Brickworks/Brickworks-Card-Templates/HAB-Main-Flight-Computer-Card-Template/MFC-Card-TemplateV2.step

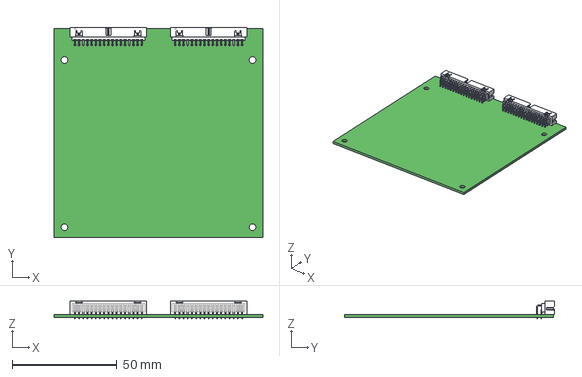
[picture p1: CAD file, 2020-08-18]
HAB-Main-Flight-Computer-Card-Template/MFC-Card-TemplateV2.step
100.0 x 100.7 x 8.46 mm
