Brickworks/Brickworks-Card-Templates/HAB-Payload-Card-Template/Payload-Card-TemplateV2.step

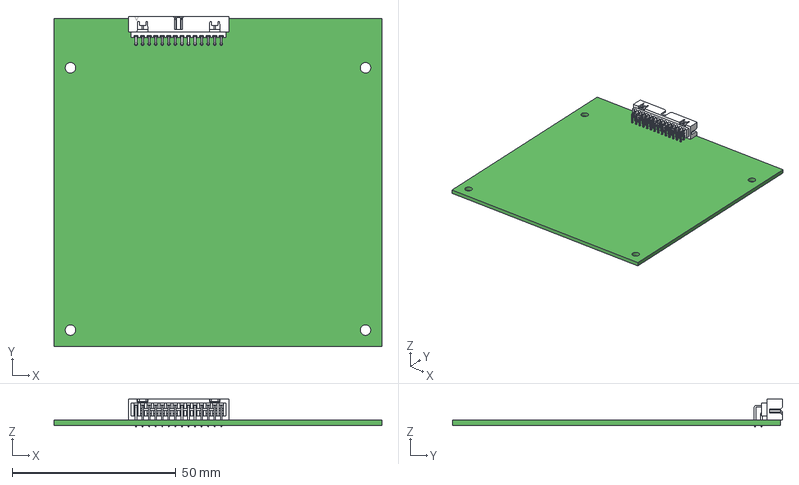
[picture p2: CAD file, 2020-08-18]
HAB-Payload-Card-Template/Payload-Card-TemplateV2.step
100.0 x 100.6 x 8.46 mm
