Brickworks/Brickworks-Card-Templates/HAB-Main-Flight-Computer-Card-Template/MFC-Card-TemplateV1.step

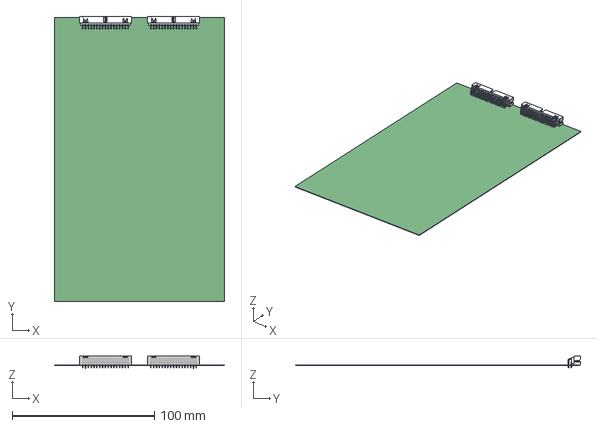
[picture p3: CAD file, 2020-08-17, an earlier design]
HAB-Main-Flight-Computer-Card-Template/MFC-Card-TemplateV1.step
120.0 x 200.7 x 8.46 mm
