Brickworks/Brickworks-Card-Templates/HAB-Payload-Card-Template/Payload-Card-TemplateV1.step

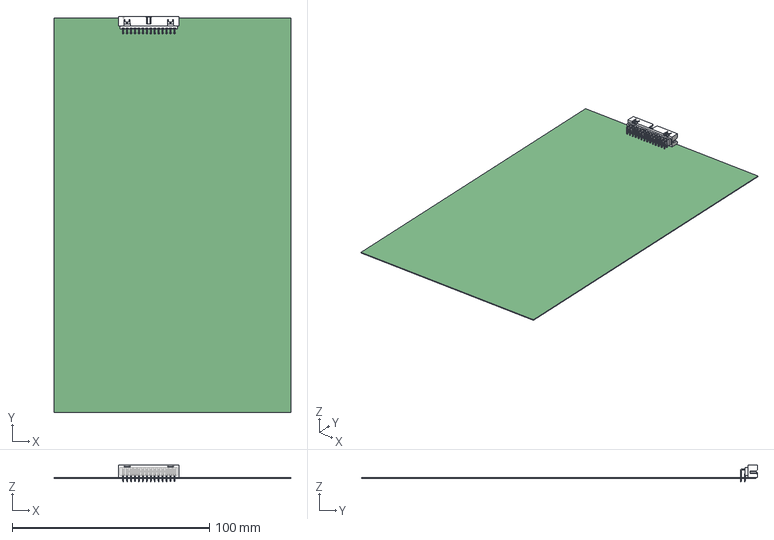
[picture p4: CAD file, 2020-08-17, an earlier design]
HAB-Payload-Card-Template/Payload-Card-TemplateV1.step
120.0 x 200.6 x 8.46 mm
