Brickworks/Brickworks-Card-Templates/HAB-Main-Flight-Computer-Card-Template/HAB-Main-Flight-Computer-Card-Template.pdf

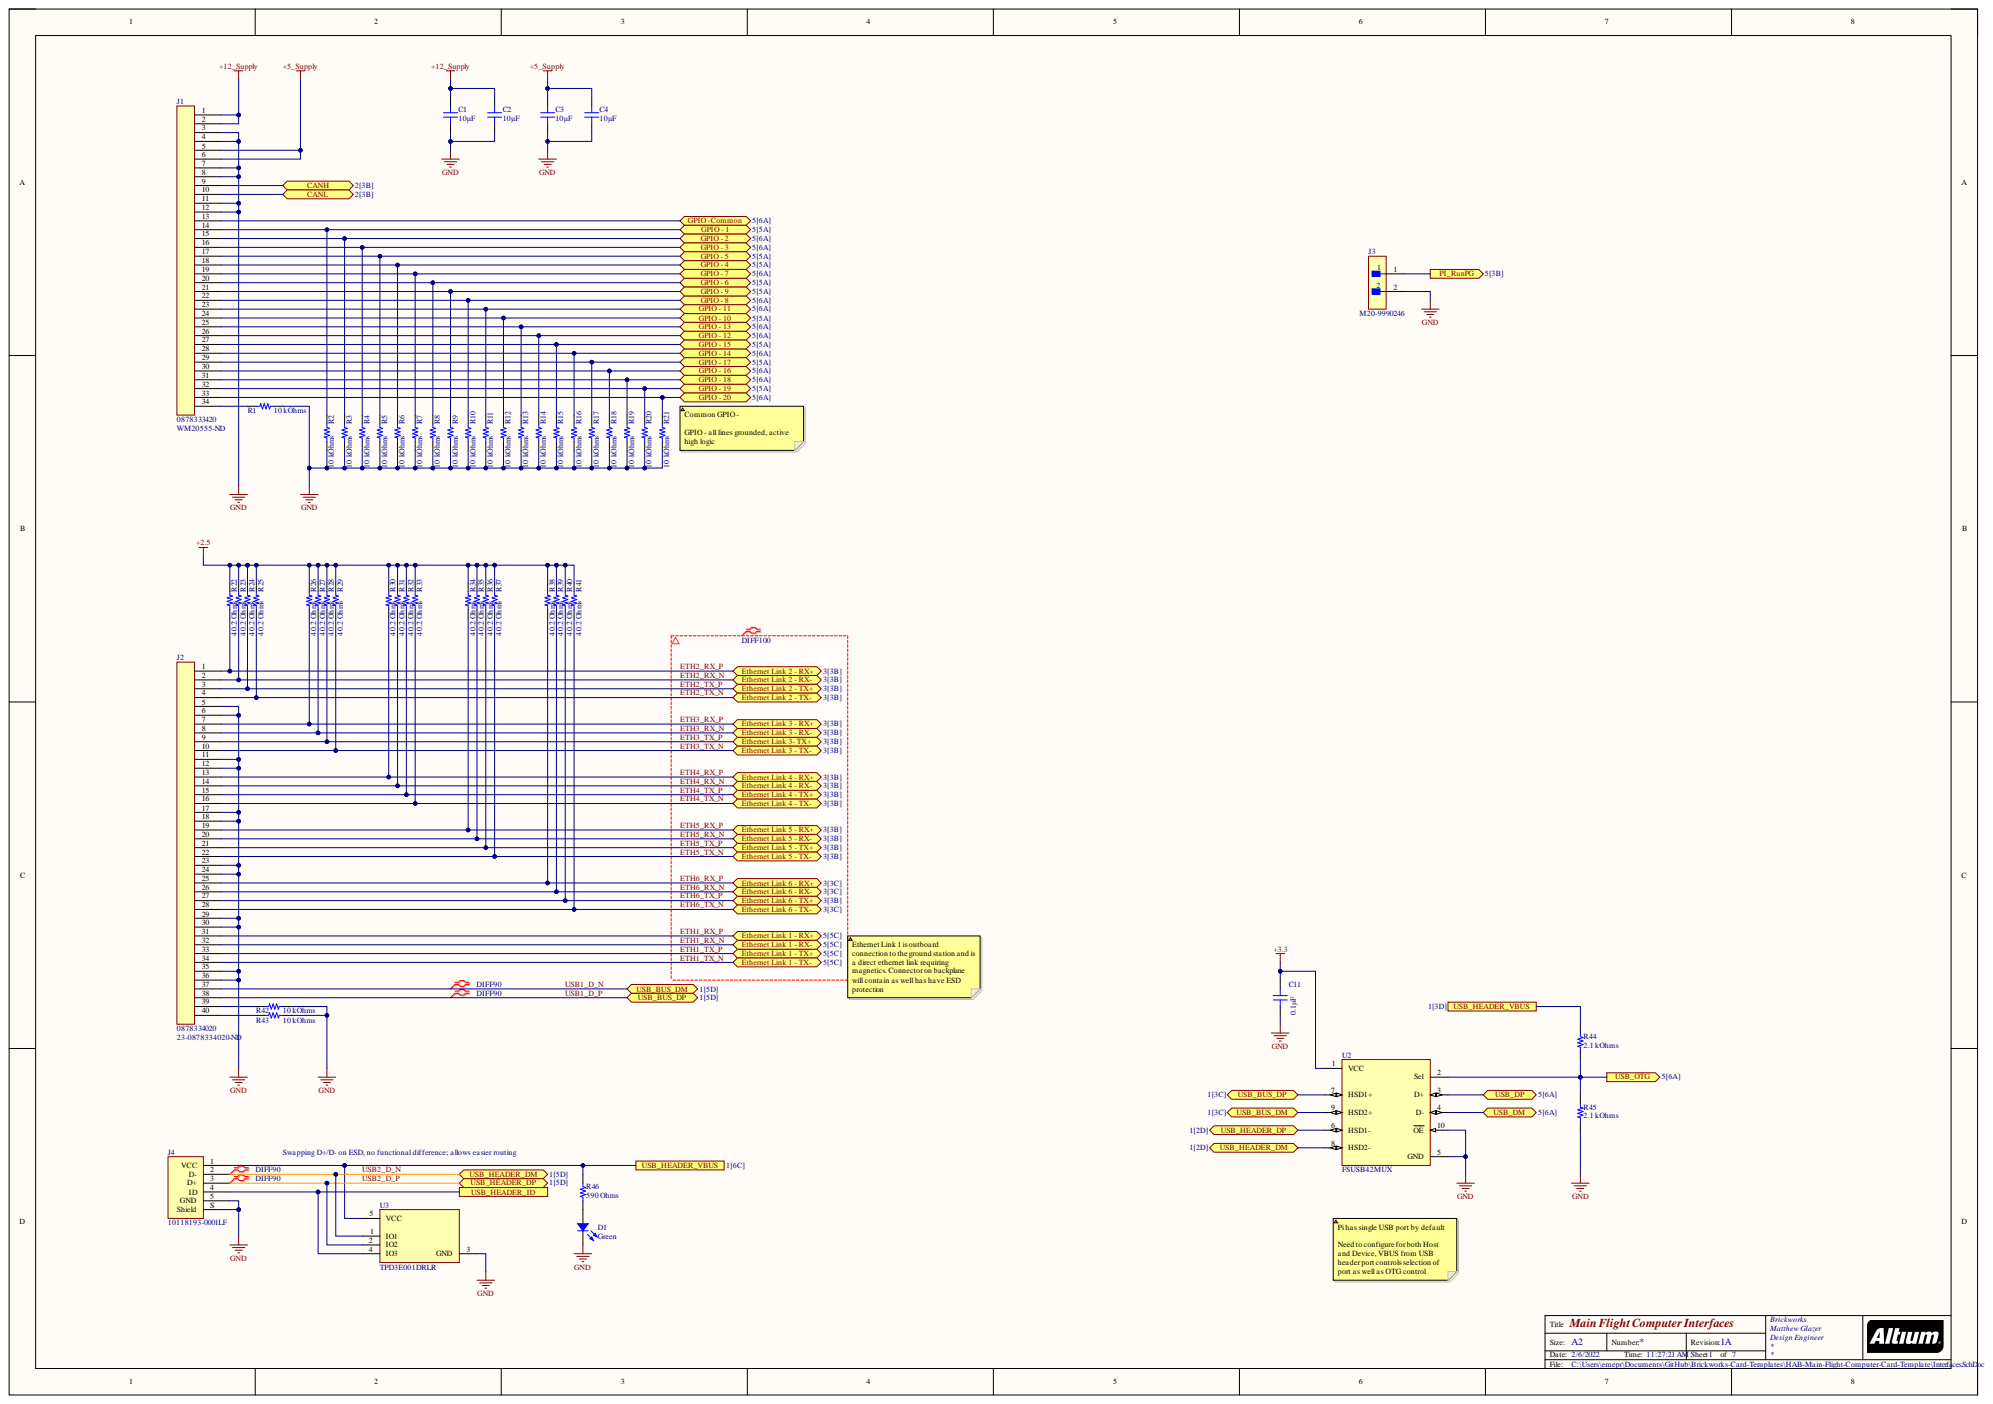
[picture p5: page 1]

GPIO - all lines grounded, active
high logic

Ethernet Link 1 is outboard
connection to the ground station and is
a direct ethernet link requiring
magnetics.Connector on backplane
will contain as well has have ESD
protection

36
37
38 | DIFF90 USB1_D_P

Swapping D+/D- on ESD, no functional difference; allows easier routing

DIFF90

Pi has single USB port by default

Need to configure for both Host
and Device, VBUS from USB
header port controls selection of
port as well as OTG control

C:\Users\emepr\Documents\GitHub\Brickworks-Card-Templates\HAB-Main-Flight-Computer-Card-Template\Interfaces.SchDoc

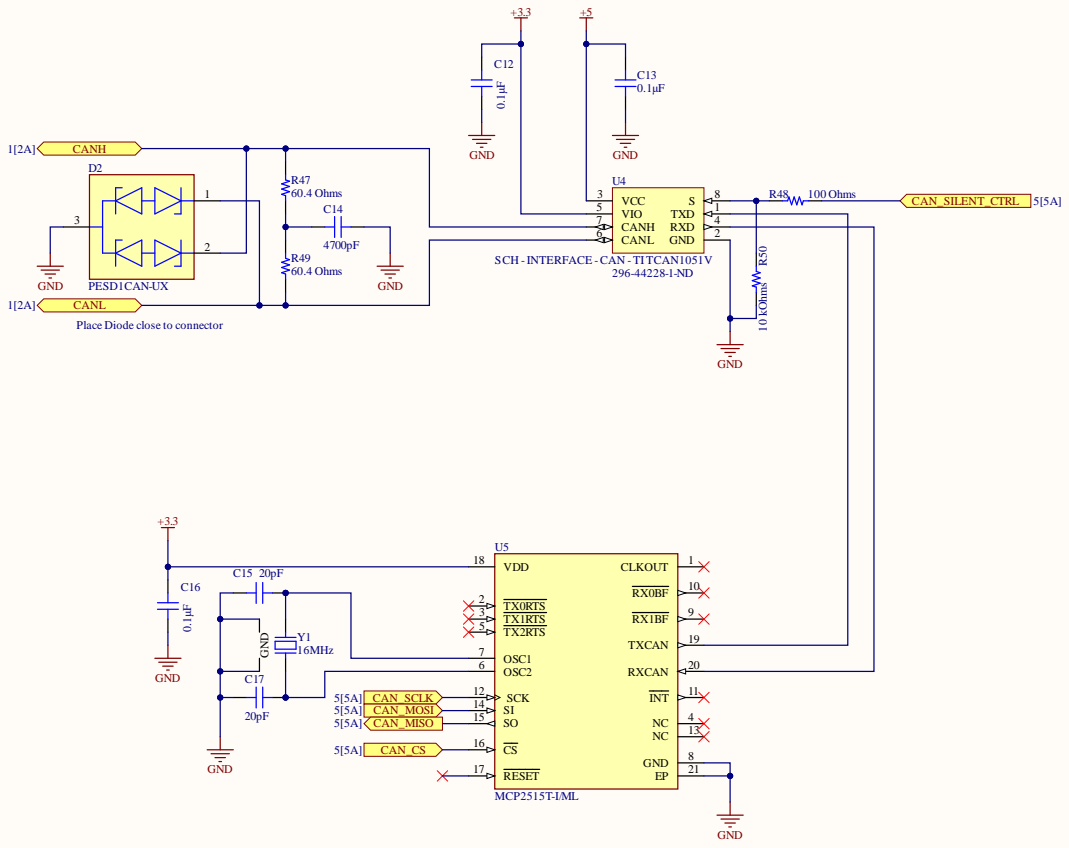
[picture p6: page 2]

Place Diode close to connector

Main Flight Computer CAN Bus
Title

C:\Users\emepr\Documents\GitHub\Brickworks-Card-Templates\HAB-Main-Flight-Computer-Card-Template\CANbus.SchDoc

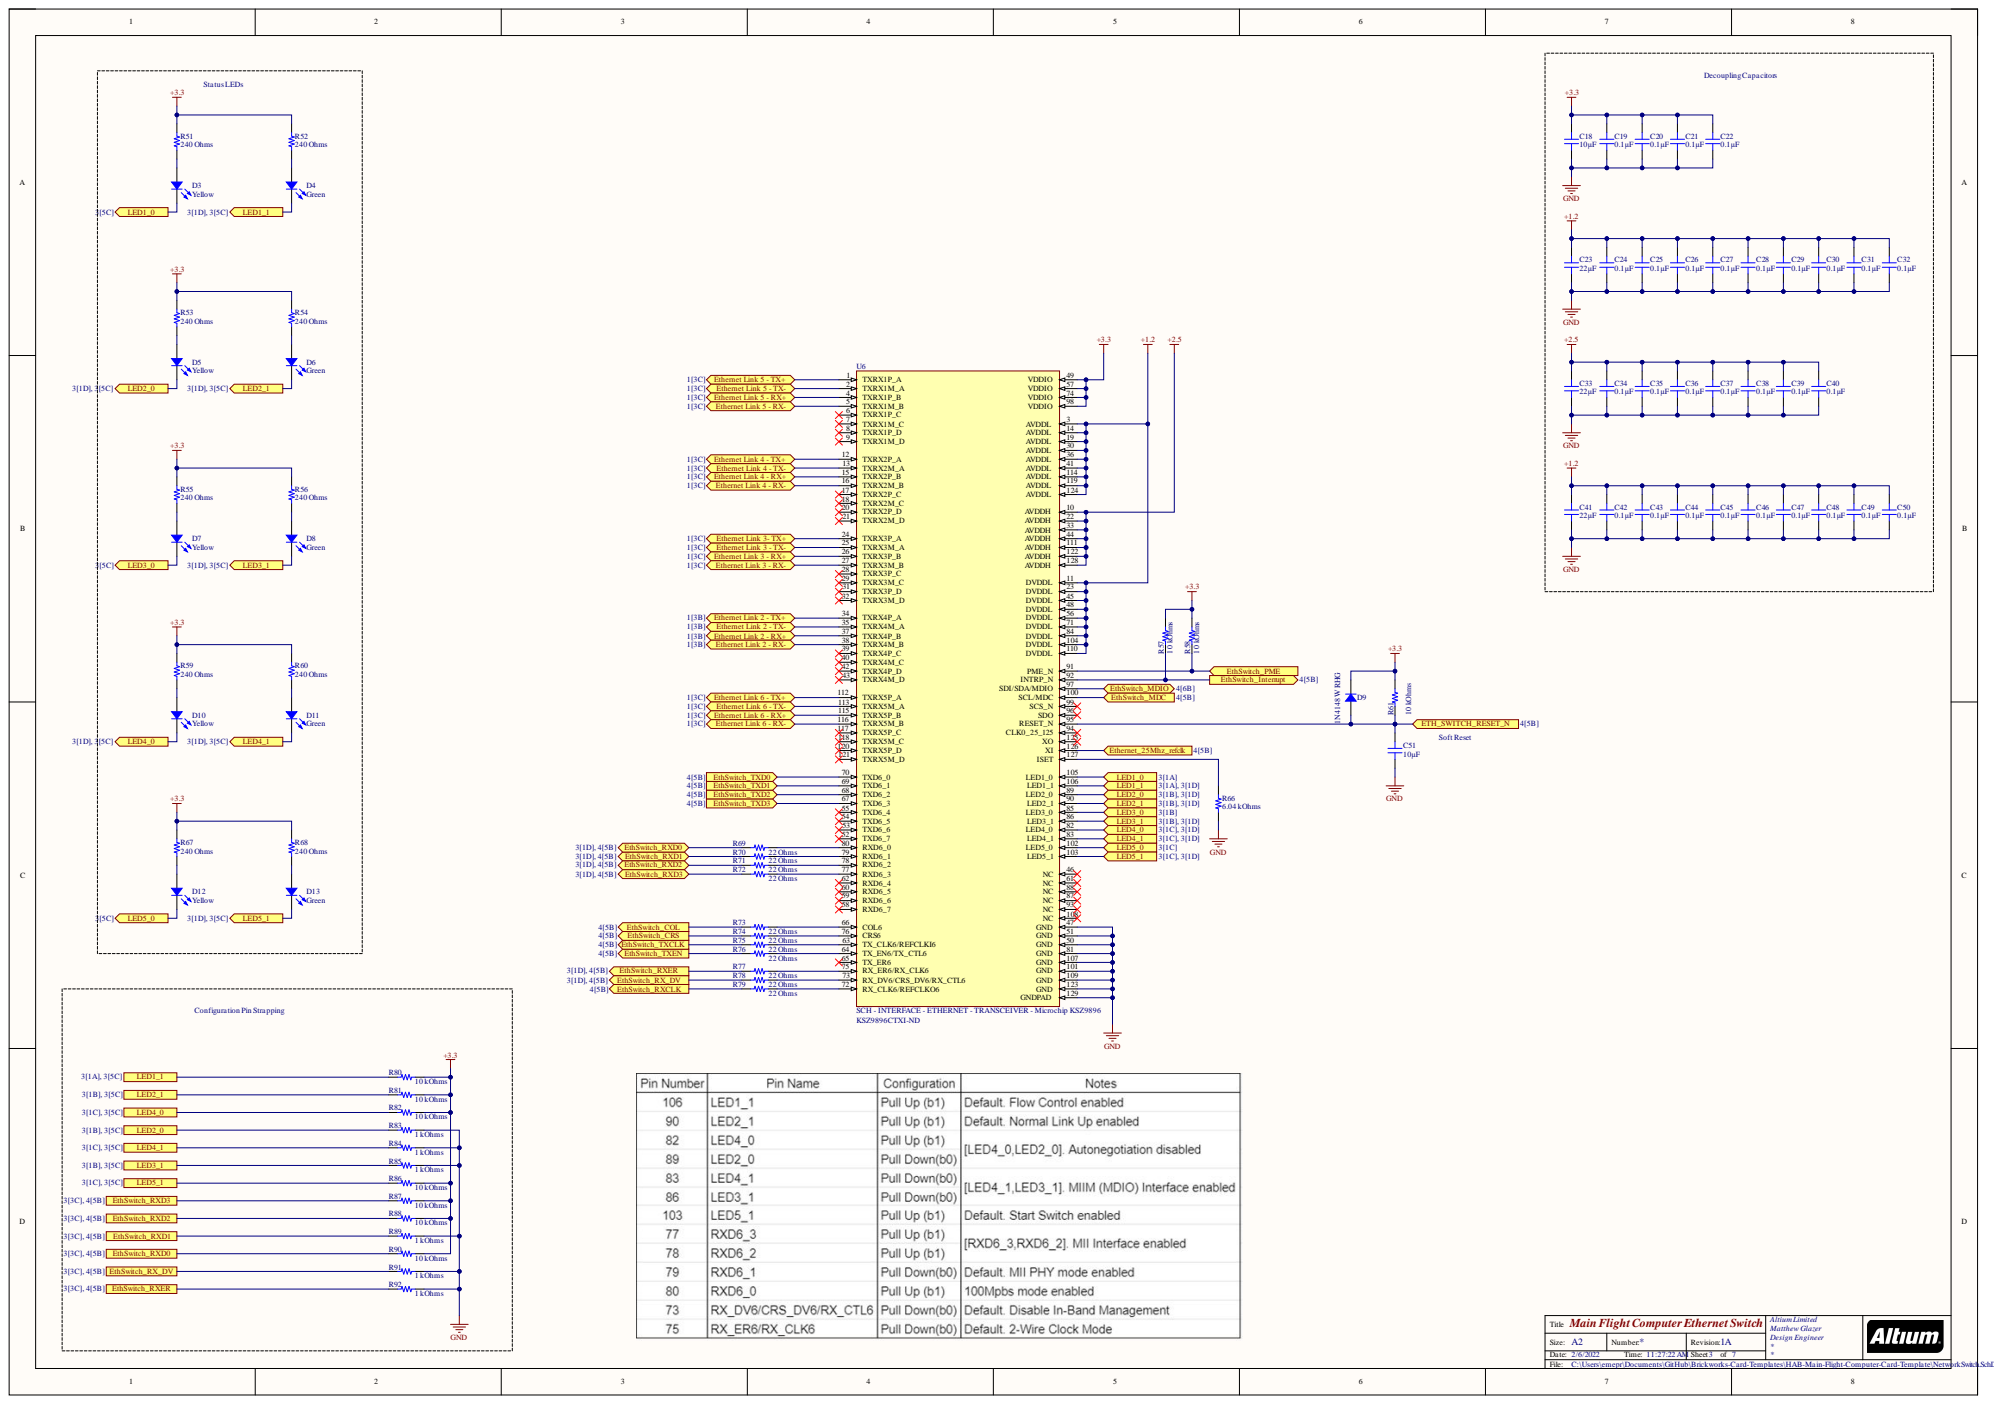
[picture p7: page 3]

5 1
5 0

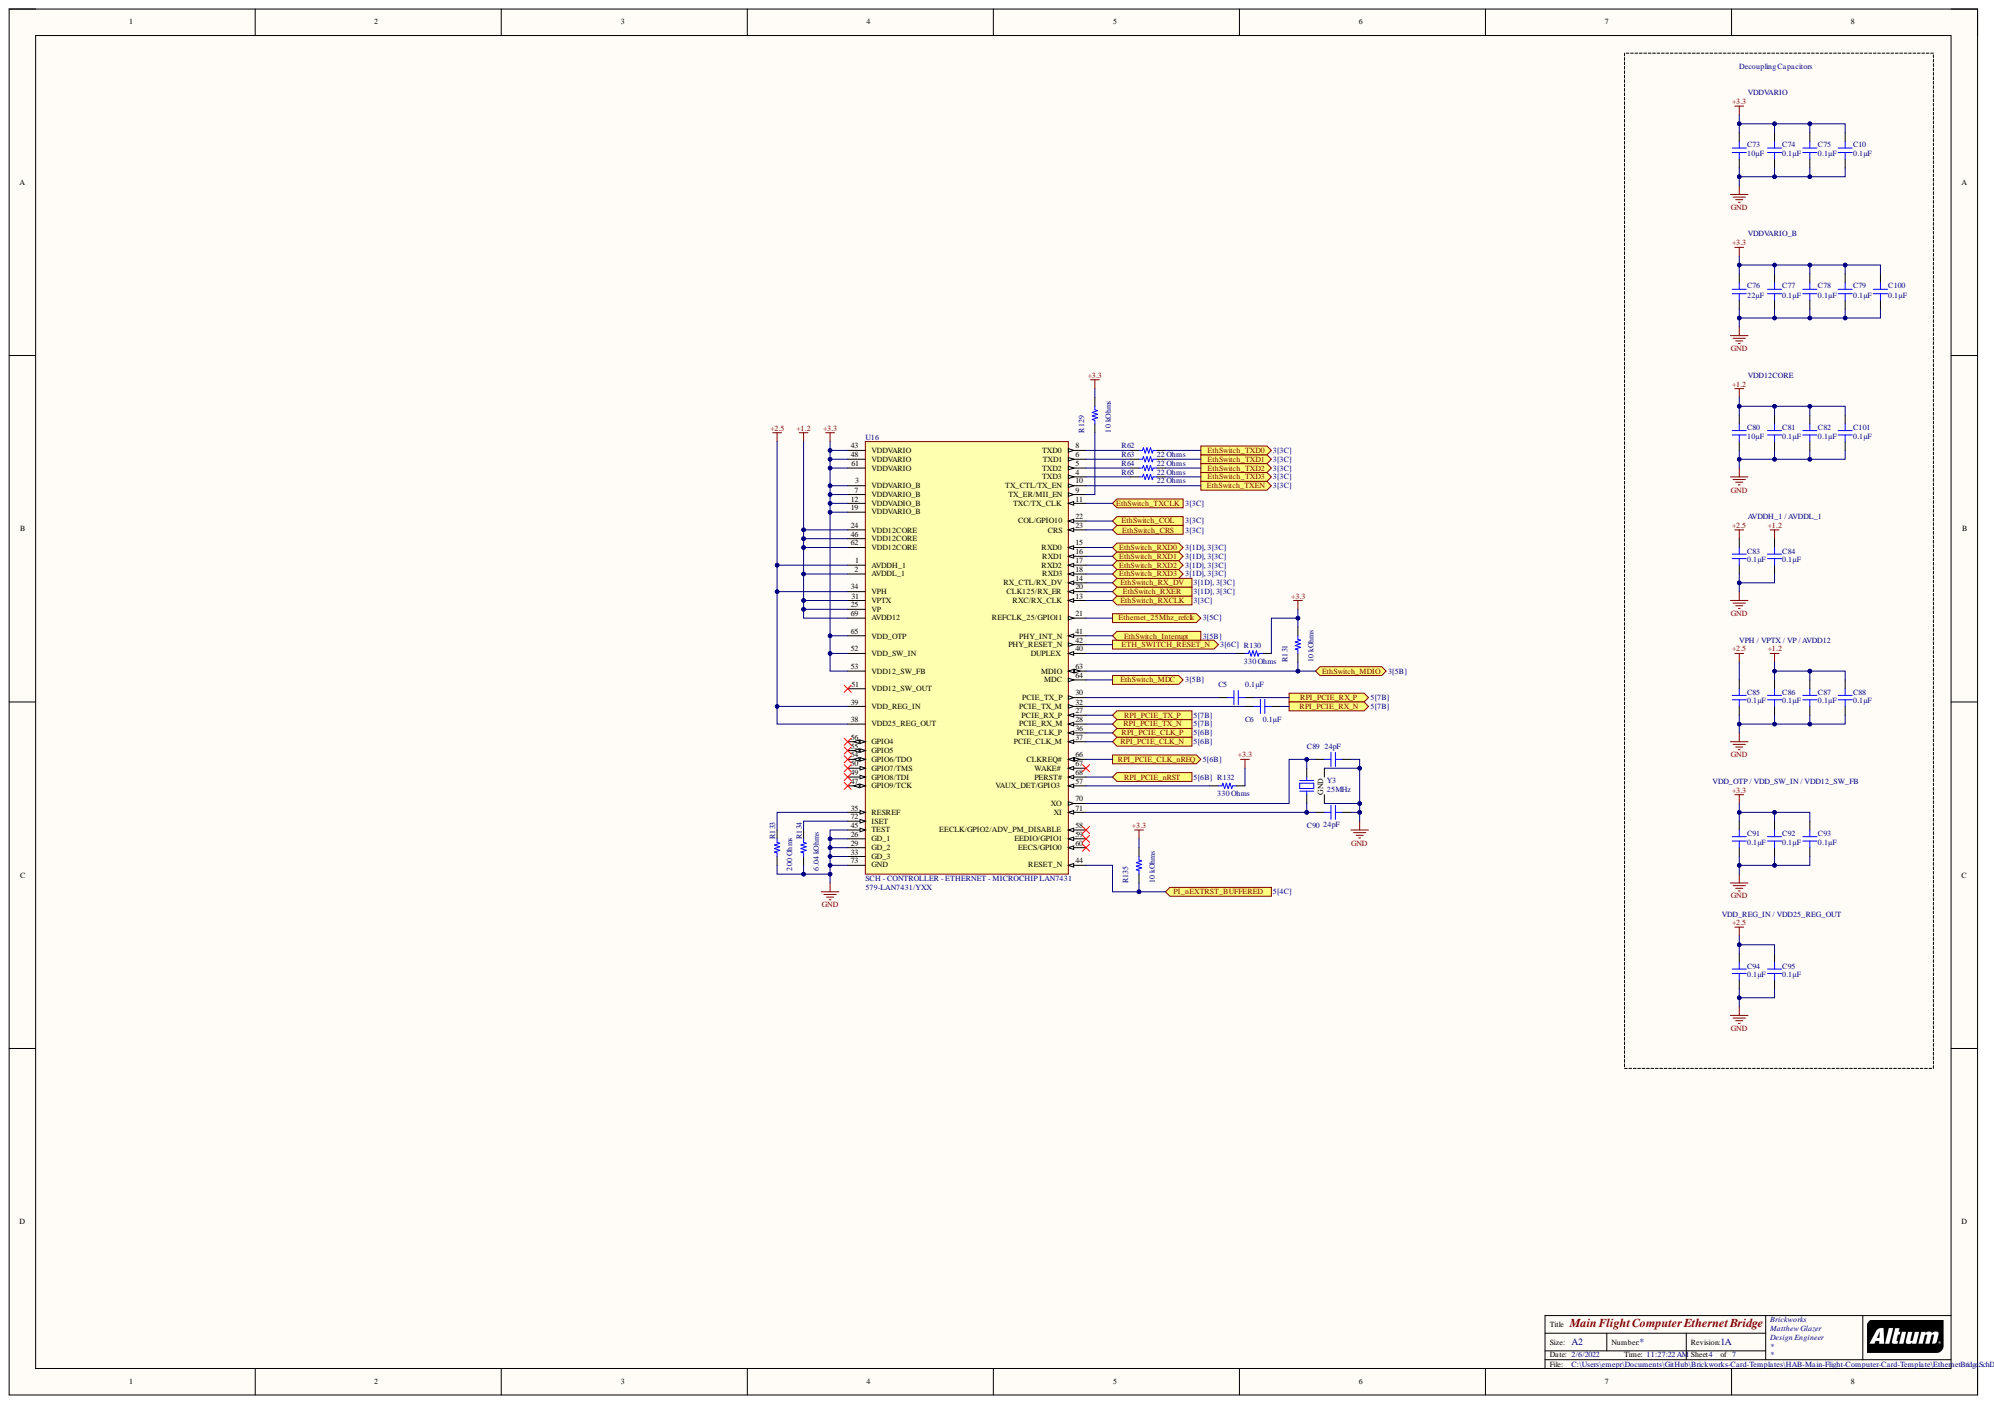
[picture p8: page 4]

4 6
6 2

3 4
3 1
2 5
6 9

6 7 | R P I _ P C IE_ CLK_ n REQ 5 [ 6 B ] 3 3 0 O hms
6 8 5 7 7 0 | | Y 3 2 5 M H z

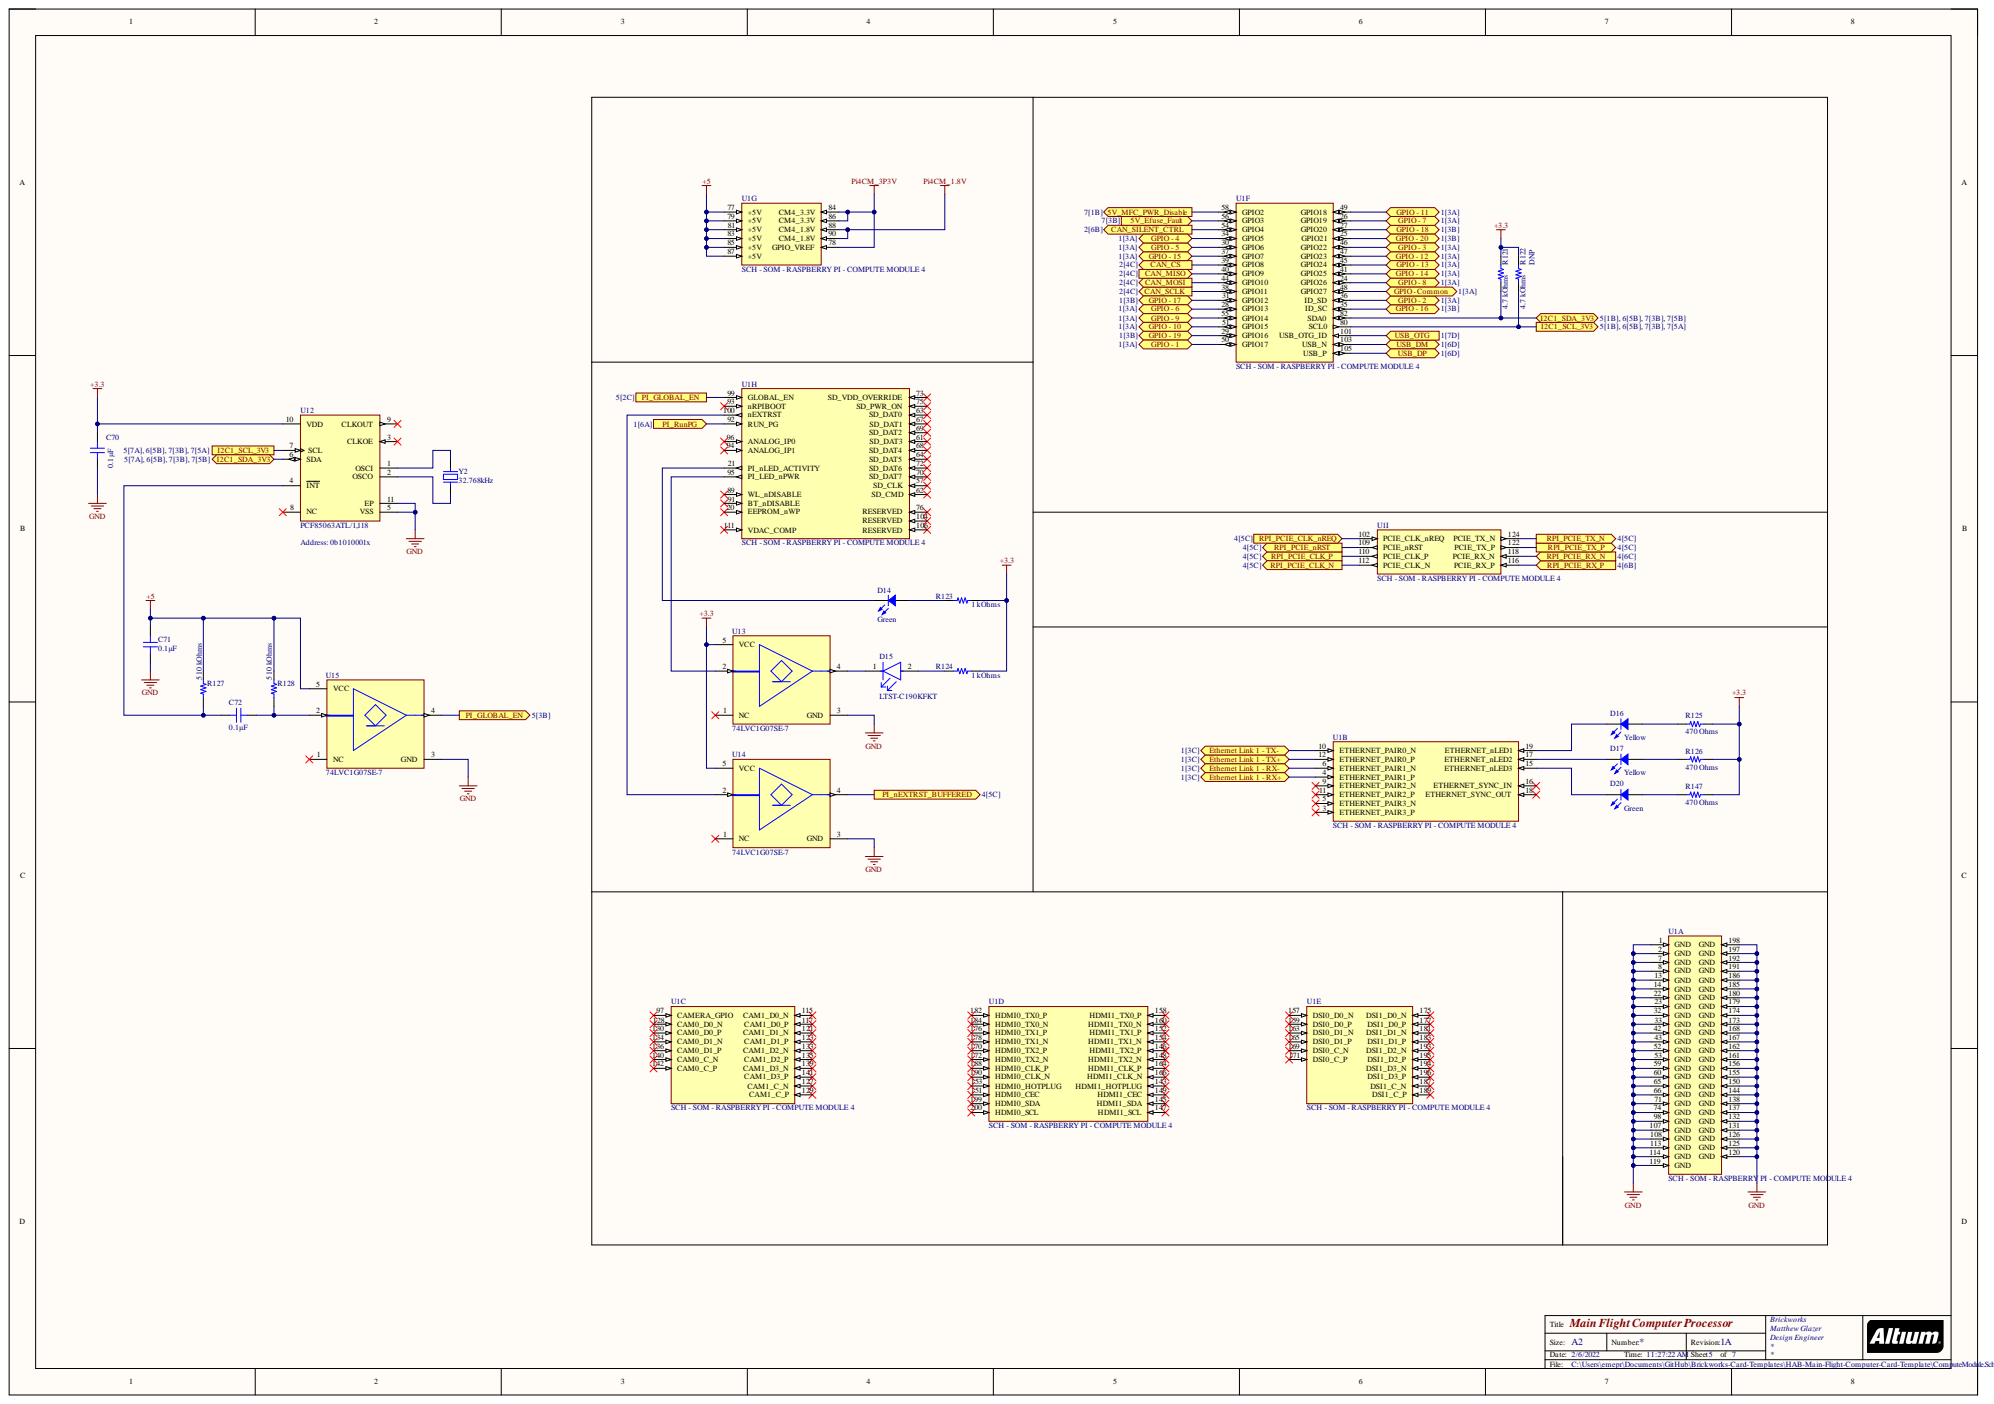
[picture p9: page 5]

SCH - SOM - RASPBERRY PI - COMPUTE MODULE 4

PI_LED_nPWR 95

WL_nDISABLE 89

C:\Users\emepr\Documents\GitHub\Brickworks-Card-Templates\HAB-Main-Flight-Computer-Card-Template\ComputeModule.SchDoc

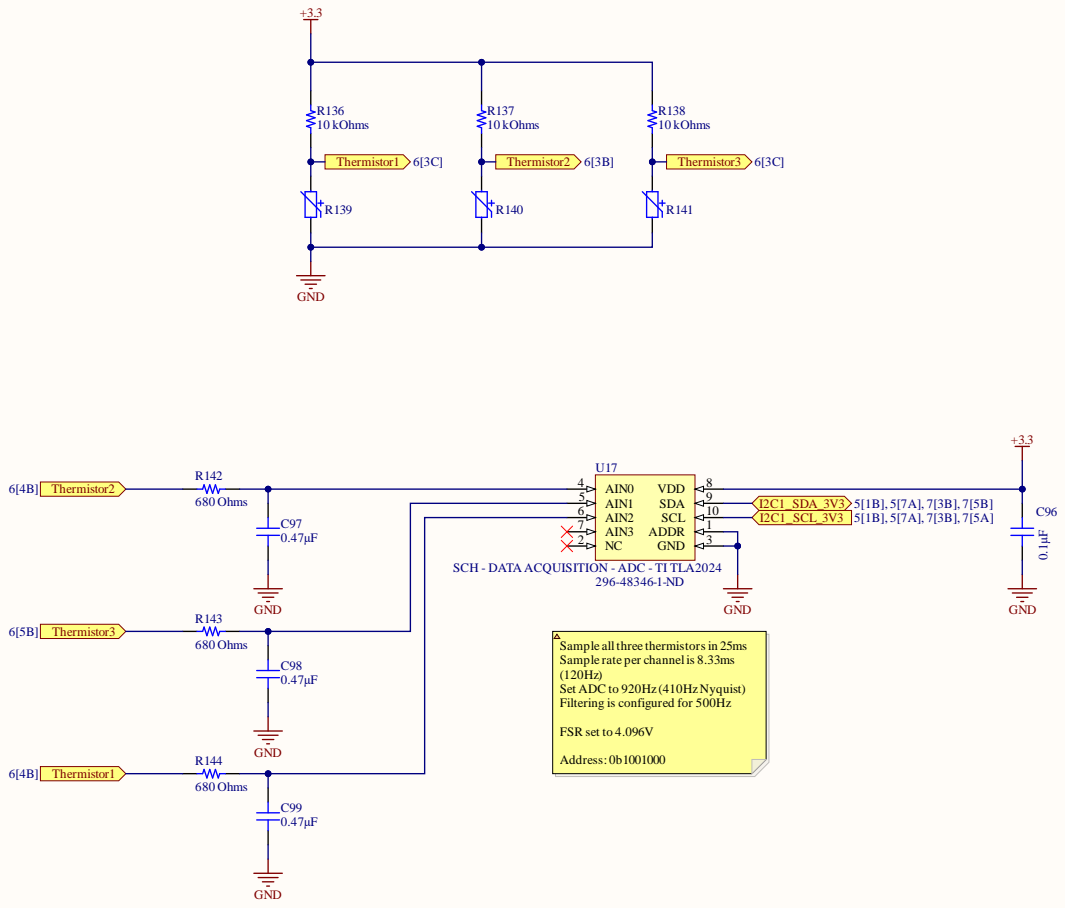
[picture p10: page 6]

SCH - DATA ACQUISITION - ADC - TI TLA2024

Sample all three thermistorsin 25ms
Sample rate per channel is 8.33ms
Set ADC to 920Hz (410HzNyquist)
Filtering is configured for 500Hz

Main Flight Computer Sensors
Title

C:\Users\emepr\Documents\GitHub\Brickworks-Card-Templates\HAB-Main-Flight-Computer-Card-Template\Sensors.SchDoc

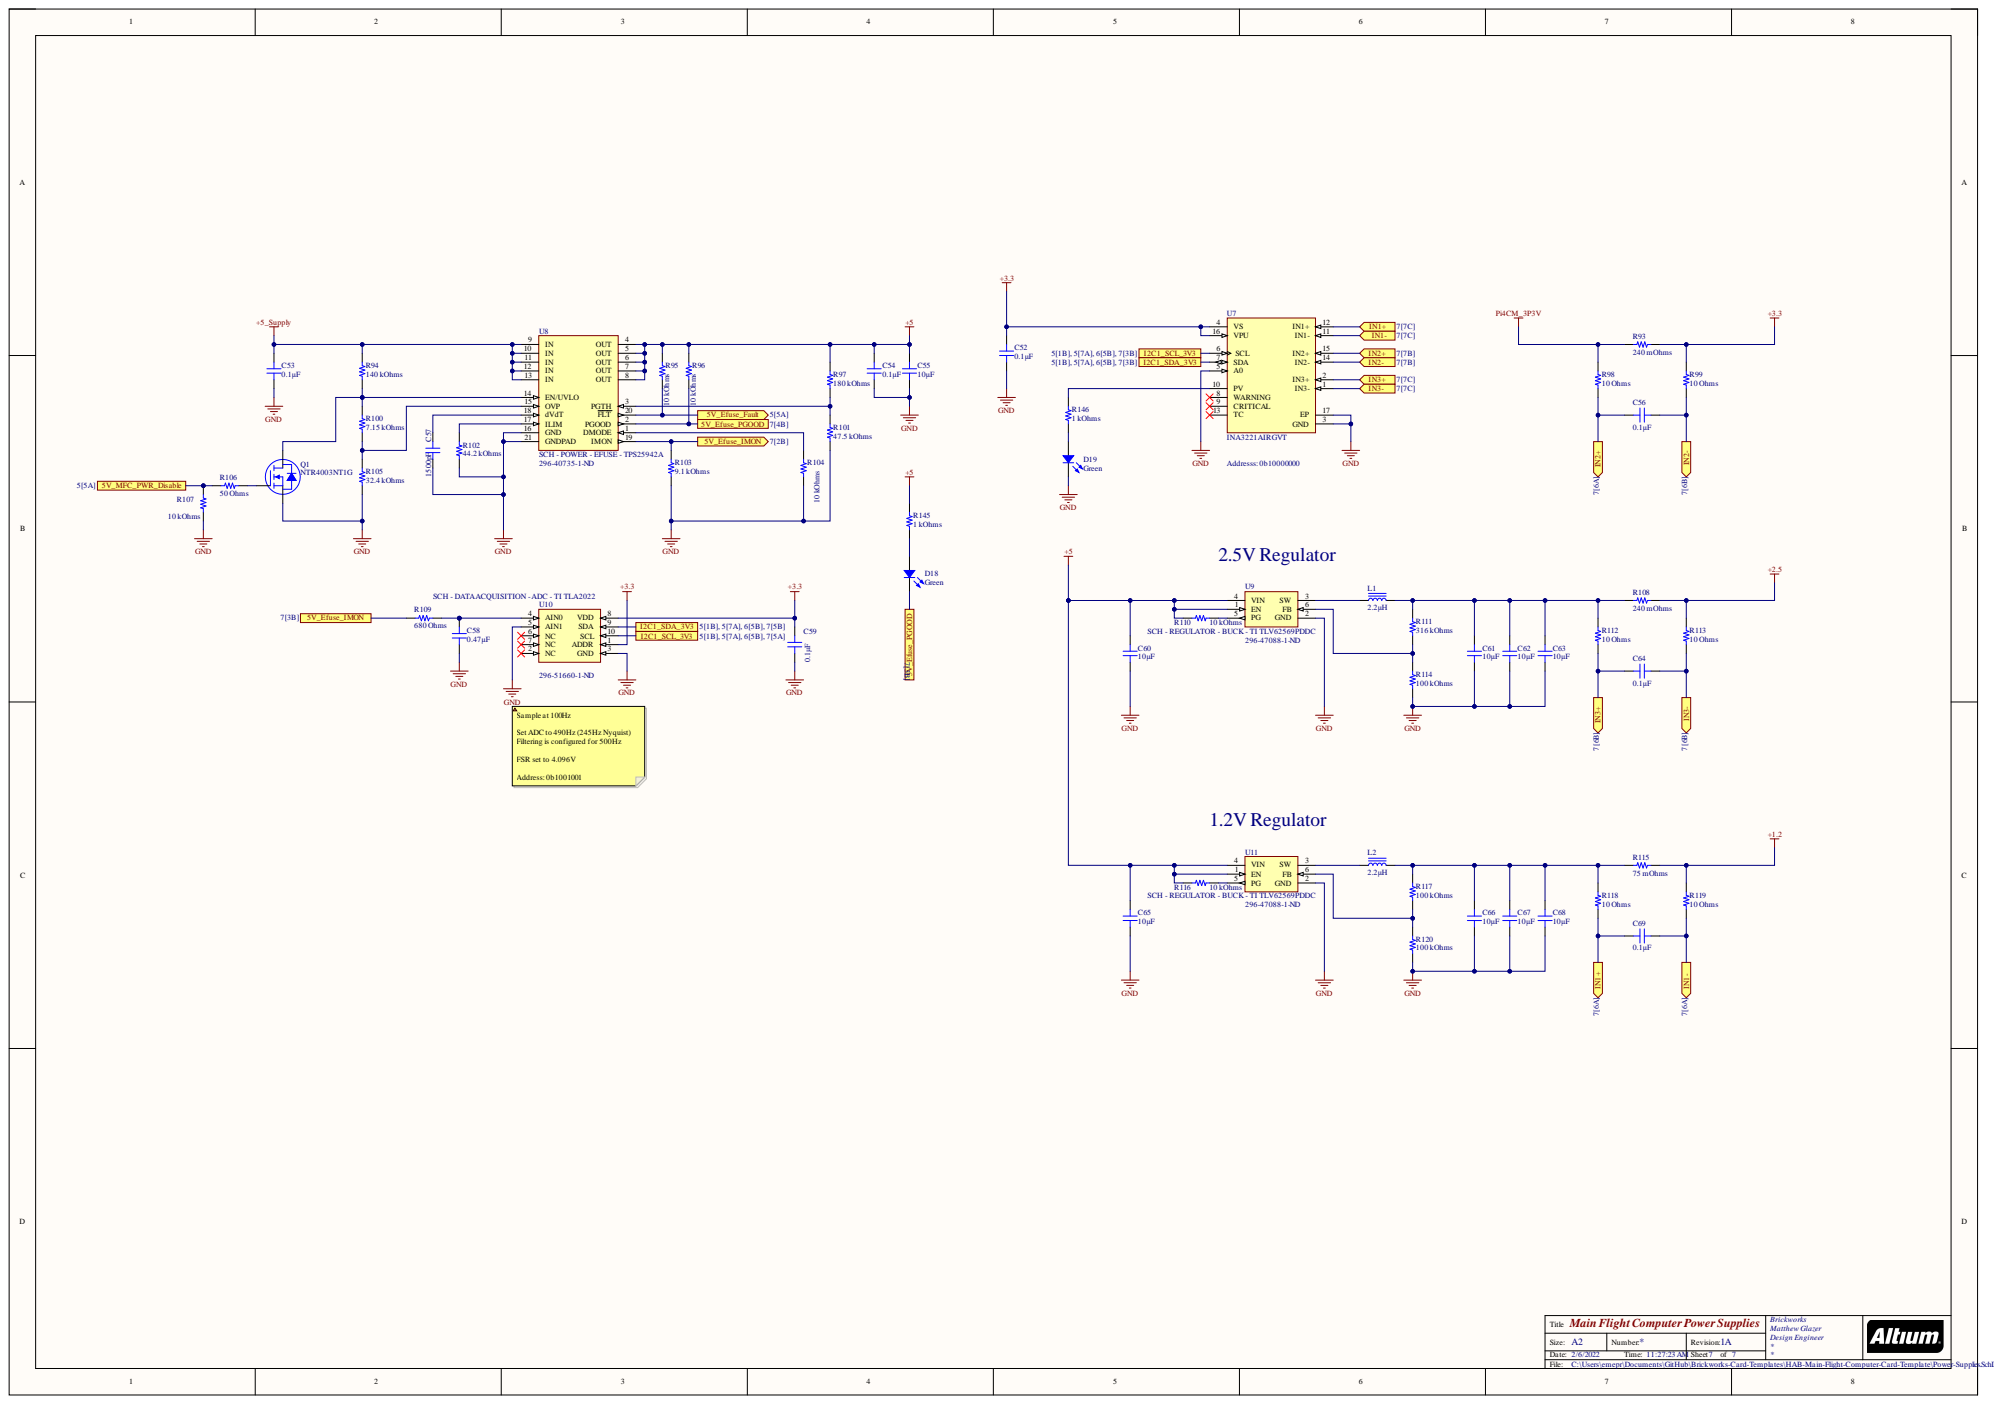
[picture p11: page 7]

2 1 | | 5 V_Efuse _ I M ON 7 [ 2 B ]

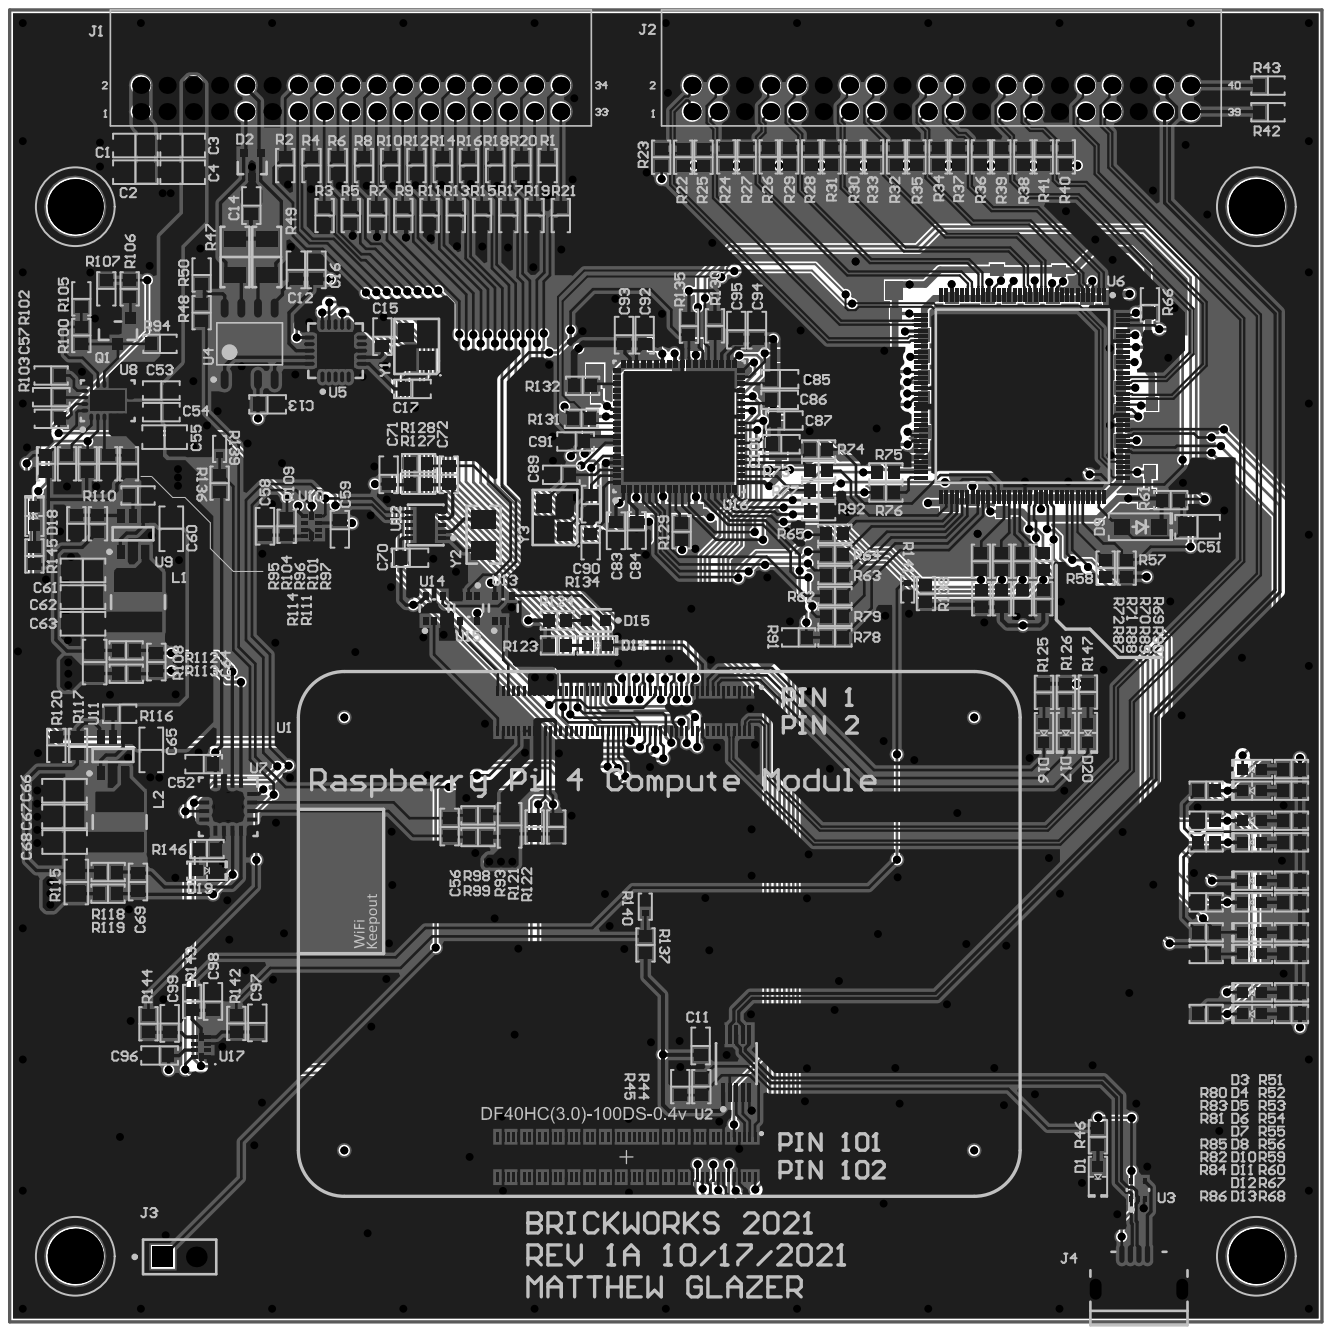
[picture p12: page 8]
