Brickworks/Brickworks-Card-Templates/HAB-Main-Flight-Computer-Card-Template/MFC_Draftsman.pdf

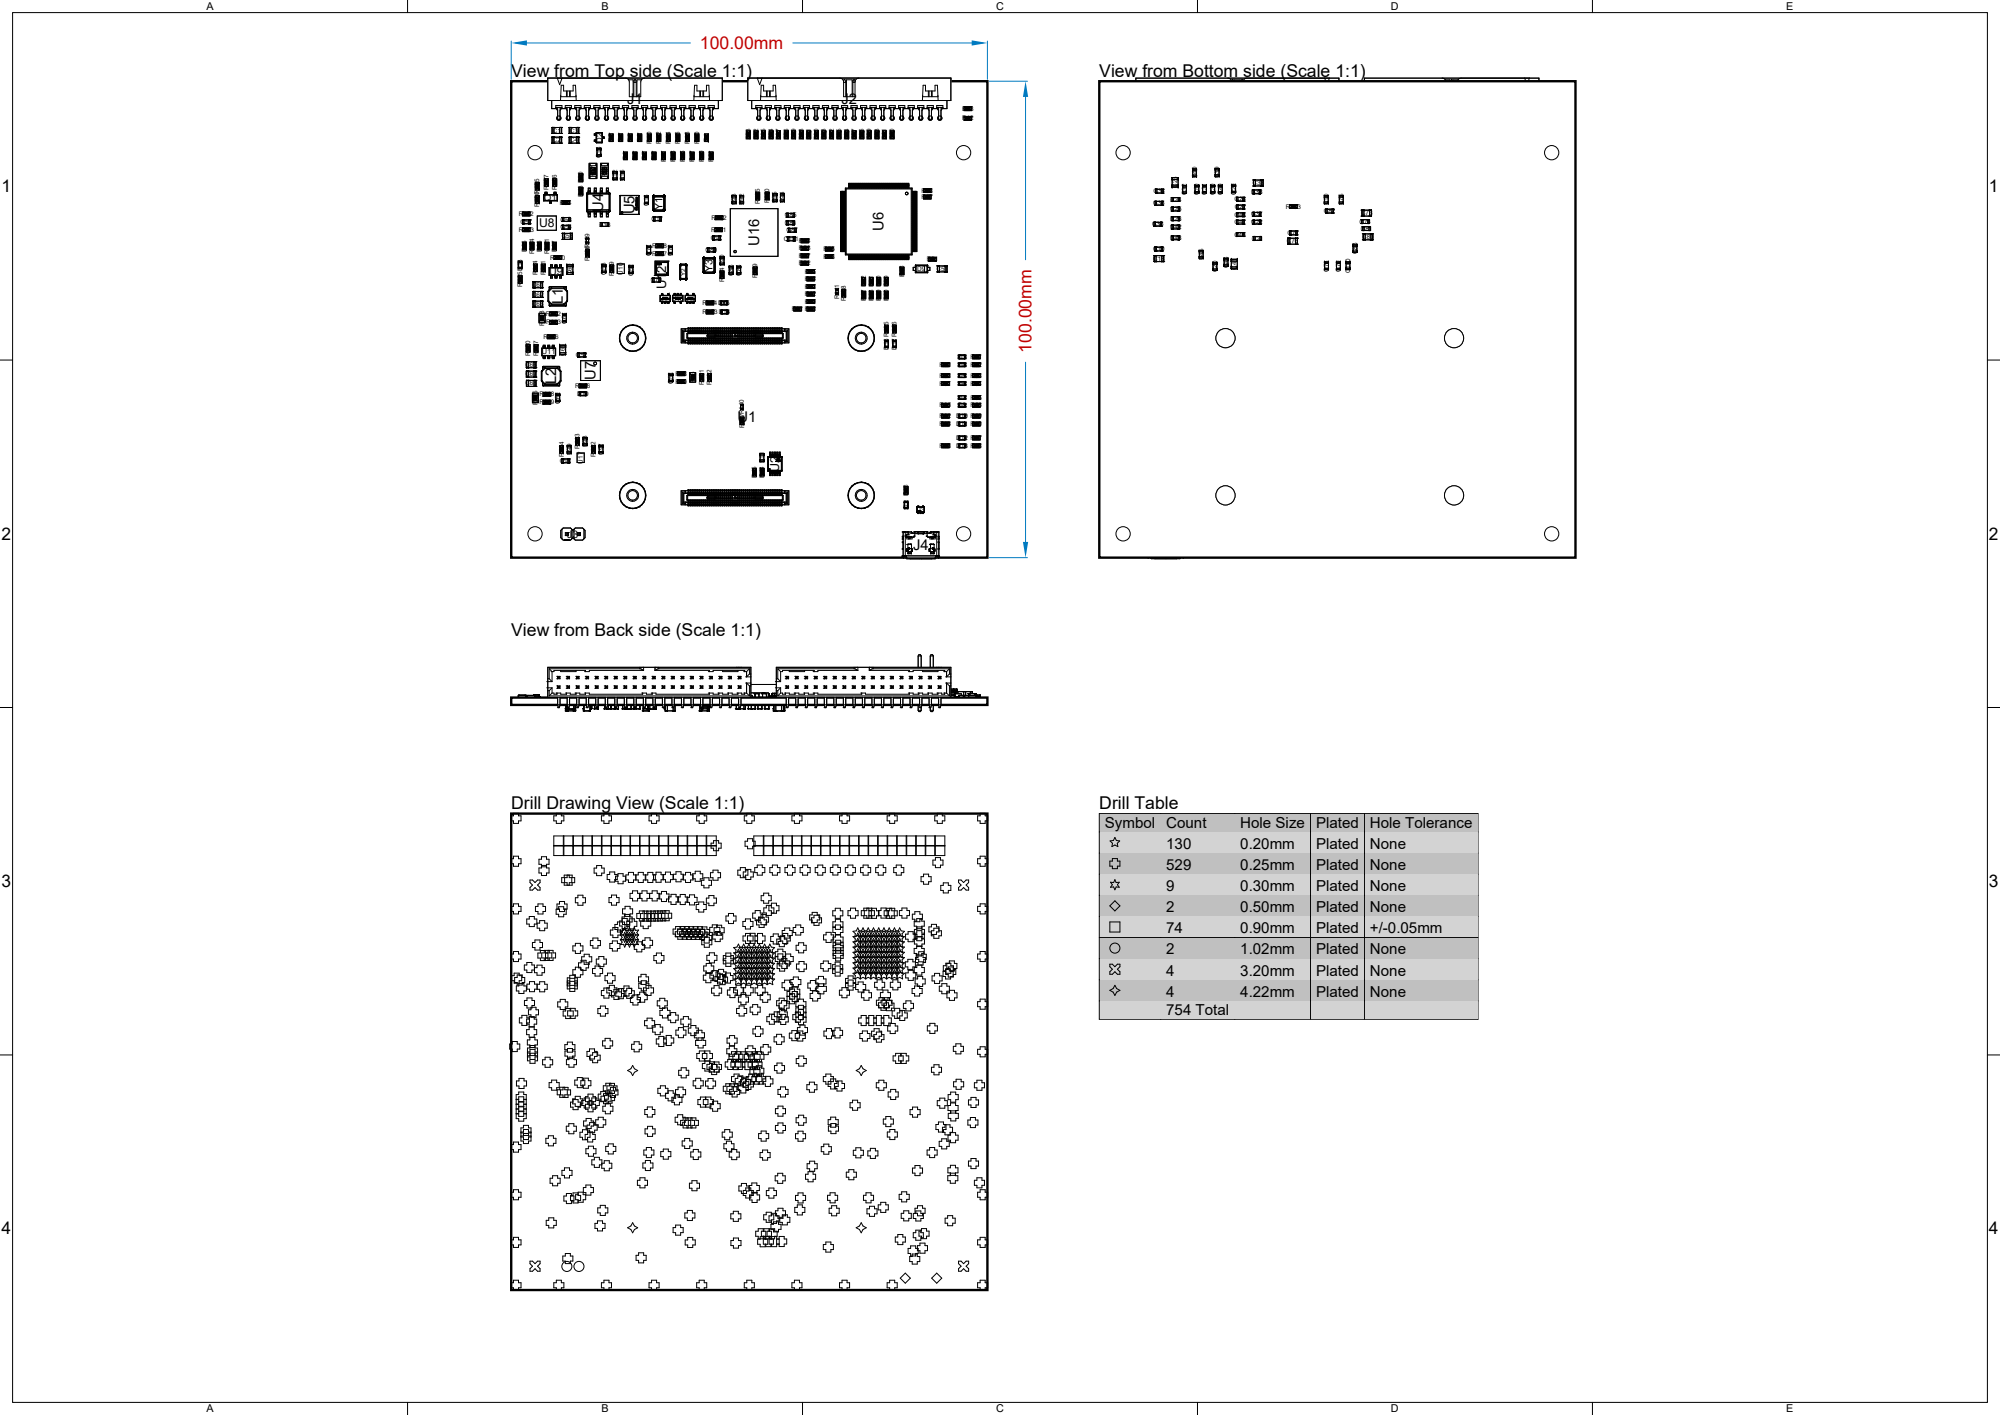
[picture p13: page 1]

View from Top side (Scale 1:1)

View from Bottom side (Scale 1:1)

View from Back side (Scale 1:1)

Drill Drawing View (Scale 1:1)

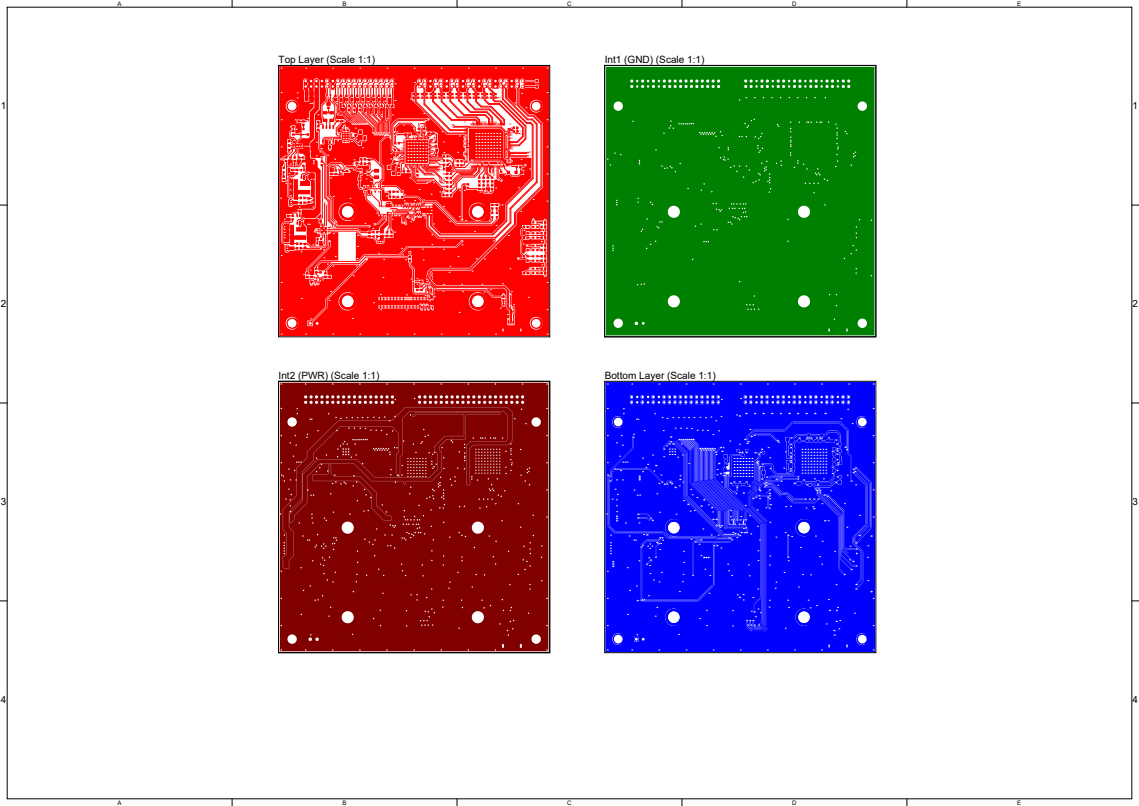
[picture p14: page 2]
Int2 (PWR) (Scale 1:1); Top Layer (Scale 1:1); Int1 (GND) (Scale 1:1)

Bottom Layer (Scale 1:1)

1 | 1
2 | 2
3 | 3
4 | 4

Impedance Id
1
2
3
4

Transmission Line
Edge-Coupled Coated Microstrip Edge-Coupled Coated Microstrip Edge-Coupled Coated Microstrip Edge-Coupled Coated Microstrip

Target Impedance
100
90
100
90

Calculated Impedance
100.03
89.98
100.03
89.98

Trace layer
Top Layer
Top Layer
Bottom Layer
Bottom Layer

Lower Trace Width
0.17mm
0.24mm
0.17mm
0.24mm

Upper Trace Width
0.17mm
0.24mm
0.17mm
0.24mm

Gap
0.13mm
0.13mm
0.13mm
0.13mm

Reference layers
Int1 (GND)
Int1 (GND)
Int2 (PWR)
Int2 (PWR)

Substack
Board Layer Stack
Board Layer Stack
Board Layer Stack
Board Layer Stack

Transmission Line Structure Table

Material | Layer | Thickness Dielectric Material Type | Gerber
Top Overlay | Legend | GTO
Surface Material Top Soldermask | 0.01mm | SM-001 | Solder Mask | GTS
Nickel, Gold | Top Surface Finish | 0.02mm | Surface Finish
CF-004 | Top Layer | 0.04mm | Signal | GTL
Prepreg | 0.23mm | PP-018 | Dielectric
CF-004 | Int1 (GND) | 0.04mm | Internal Plane GP1
Core | 0.93mm | Core-028 | Dielectric
CF-004 | Int2 (PWR) | 0.04mm | Internal Plane GP2
Prepreg | 0.23mm | PP-018 | Dielectric
CF-004 | Bottom Layer | 0.04mm | Signal | GBL
Nickel, Gold | Bottom Surface Finish 0.02mm | Surface Finish
Surface Material Bottom Soldermask | 0.01mm | SM-001 | Solder Mask | GBS
Bottom Overlay | Legend | GBO
Total thickness: 1.60mm

Layer Stack Legend
