Brickworks/Brickworks-Card-Templates/(list of files, drawings)

Other design files:
HAB-Main-Flight-Computer-Card-Template/CANbus.SchDoc
HAB-Main-Flight-Computer-Card-Template/ComputeModule.SchDoc
HAB-Main-Flight-Computer-Card-Template/EthernetBridge.SchDoc
HAB-Main-Flight-Computer-Card-Template/HAB-Main-Flight-Computer-Card-Template.PrjPcb
HAB-Main-Flight-Computer-Card-Template/Interfaces.SchDoc
HAB-Main-Flight-Computer-Card-Template/MFC-Card-Template.PcbDoc
HAB-Main-Flight-Computer-Card-Template/NetworkSwitch.SchDoc
HAB-Main-Flight-Computer-Card-Template/Power-Supplies.SchDoc
HAB-Main-Flight-Computer-Card-Template/Processor-2.SchDoc
HAB-Main-Flight-Computer-Card-Template/Processor.SchDoc
HAB-Main-Flight-Computer-Card-Template/Sensors.SchDoc
HAB-Main-Flight-Computer-Card-Template/Transceivers.SchDoc
HAB-Payload-Card-Template/HAB-Payload-Card-Template.PrjPcb
HAB-Payload-Card-Template/Microcontroller.SchDoc
HAB-Payload-Card-Template/Payload-Card-Template.PcbDoc
HAB-Payload-Card-Template/Payload-Card-Template.SchDoc
HAB-Payload-Card-Template/Power-Supplies.SchDoc
