Brickworks/Brickworks-Card-Templates/(commit log)

2020-08-17 added basic templates for the MFC and payload cards, more work to be done
    [HAB-Main-Flight-Computer-Card-Template.PrjPcb, HAB-Payload-Card-Template.PrjPcb, MFC-Card-Template.PcbDoc, MFC-Card-Template.SchDoc, MFC-Card-TemplateV1.step, Payload-Card-Template.PcbDoc, Payload-Card-Template.SchDoc, Payload-Card-TemplateV1.step]
2020-08-18 card templates size tweaked and added mounting holes
    [HAB-Payload-Card-Template.PrjPcb, MFC-Card-Template.PcbDoc, MFC-Card-TemplateV2.step, Payload-Card-Template.PcbDoc, Payload-Card-TemplateV2.step]
2020-08-26 refactored into multisheet, added the octavo SoM to the schematic, started basic wiring
    [HAB-Main-Flight-Computer-Card-Template.PrjPcb, Interfaces.SchDoc, MFC-Card-Template.SchDoc, Processor-2.SchDoc, Processor.SchDoc]
2020-09-01 Working on interfaces and MFC processor
    [HAB-Main-Flight-Computer-Card-Template.PrjPcb, Interfaces.SchDoc, Payload-Card-Template.SchDoc, Processor.SchDoc]
2020-09-05 CAN transceiver scehatmic block done
    [Interfaces.SchDoc, MFC-Card-Template.PcbDoc, Payload-Card-Template.SchDoc, Processor.SchDoc]
2020-09-08 added the MCU to the payload card template, added the SoM to MFC PCB
    [HAB-Main-Flight-Computer-Card-Template.PrjPcb, Payload-Card-Template.SchDoc]
2020-09-08 adding some schematic sheets etc
    [HAB-Main-Flight-Computer-Card-Template.PrjPcb, HAB-Payload-Card-Template.PrjPcb, MFC-Card-Template.PcbDoc, Microcontroller.SchDoc, Payload-Card-Template.SchDoc, Power-Supplies.SchDoc]
2020-09-21 getting closer to finishing the templates
    [Interfaces.SchDoc, Microcontroller.SchDoc, Payload-Card-Template.SchDoc, Power-Supplies.SchDoc, Processor-2.SchDoc]
2020-10-01 more work on the templates, need to finish these soon
    [Interfaces.SchDoc, Microcontroller.SchDoc, Payload-Card-Template.SchDoc, Power-Supplies.SchDoc, Processor.SchDoc]
2020-10-02 more work on templates
    [Interfaces.SchDoc, Microcontroller.SchDoc, Payload-Card-Template.SchDoc, Processor.SchDoc]
2020-10-08 lots of work on the networking portion of MFC
    [HAB-Main-Flight-Computer-Card-Template.PrjPcb, Interfaces.SchDoc, NetworkSwitch.SchDoc, Payload-Card-Template.SchDoc, Processor-2.SchDoc, Processor.SchDoc, Transceivers.SchDoc]
2020-10-26 working on schematics
    [HAB-Main-Flight-Computer-Card-Template.PrjPcb, Interfaces.SchDoc, NetworkSwitch.SchDoc, Power-Supplies.SchDoc, Processor-2.SchDoc, Processor.SchDoc, Transceivers.SchDoc]
2020-11-07 continued work
    [HAB-Main-Flight-Computer-Card-Template.PrjPcb, Interfaces.SchDoc, NetworkSwitch.SchDoc, Power-Supplies.SchDoc, Processor.SchDoc, Transceivers.SchDoc]
2021-01-21 added efuse circuit
    [Interfaces.SchDoc, Power-Supplies.SchDoc, Processor.SchDoc]
2021-02-14 updated thermistor stuff, working some other stuff
    [Power-Supplies.SchDoc, Processor.SchDoc, Sensors.SchDoc]
2021-02-23 updating to pi4
    [ComputeModule.SchDoc, Power-Supplies.SchDoc, Processor-2.SchDoc, Processor.SchDoc]
2021-02-23 started conversion to pi4 proper
    [ComputeModule.SchDoc, HAB-Main-Flight-Computer-Card-Template.PrjPcb]
2021-03-09 MFC schematic should now be done
    [CANbus.SchDoc, ComputeModule.SchDoc, EthernetBridge.SchDoc, HAB-Main-Flight-Computer-Card-Template.PrjPcb, Interfaces.SchDoc, NetworkSwitch.SchDoc, Power-Supplies.SchDoc, Sensors.SchDoc]
2021-03-09 all sheets annotated
    [CANbus.SchDoc, ComputeModule.SchDoc, EthernetBridge.SchDoc, HAB-Main-Flight-Computer-Card-Template.PrjPcb, Interfaces.SchDoc, NetworkSwitch.SchDoc, Power-Supplies.SchDoc, Sensors.SchDoc]
2021-03-17 MFC schematic done
    [ComputeModule.SchDoc, Interfaces.SchDoc]
2021-04-05 completed rev1a schematic
    [CANbus.SchDoc, ComputeModule.SchDoc, EthernetBridge.SchDoc, HAB-Main-Flight-Computer-Card-Template.PrjPcb, Interfaces.SchDoc, NetworkSwitch.SchDoc, Power-Supplies.SchDoc, Sensors.SchDoc]
2021-04-11 Schematic "done", PCB design started
    [CANbus.SchDoc, ComputeModule.SchDoc, EthernetBridge.SchDoc, HAB-Main-Flight-Computer-Card-Template.PrjPcb, Interfaces.SchDoc, NetworkSwitch.SchDoc, Power-Supplies.SchDoc, Sensors.SchDoc]
2021-04-25 rough placement on PCB completed, schematics modified as needed
    [CANbus.SchDoc, ComputeModule.SchDoc, EthernetBridge.SchDoc, Interfaces.SchDoc, NetworkSwitch.SchDoc, Power-Supplies.SchDoc, Sensors.SchDoc]
2021-04-26 output schematic PDF
2021-05-08 general work
    [ComputeModule.SchDoc, HAB-Main-Flight-Computer-Card-Template.PrjPcb, Interfaces.SchDoc, NetworkSwitch.SchDoc, Sensors.SchDoc]
2021-05-21 working on PCB, schematic changes in support of PCB
    [Interfaces.SchDoc]
2021-06-08 routing in progress
    [Interfaces.SchDoc, Power-Supplies.SchDoc]
2021-06-09 working on ethernet routing
    reoriented the eth switch chip for better diff pair routing
    need to add a bunch of net rules and check layout reqs in more detail
    [NetworkSwitch.SchDoc]
2021-06-28 tweaked ethernet routing
    [Interfaces.SchDoc, Power-Supplies.SchDoc]
2021-08-25 MFC PCB up to completed rev1 pending DRC
    [ComputeModule.SchDoc, Interfaces.SchDoc, Sensors.SchDoc]
2021-10-05 readability improvements, fixing bugs
    [CANbus.SchDoc, ComputeModule.SchDoc, EthernetBridge.SchDoc, HAB-Main-Flight-Computer-Card-Template.PrjPcb, Interfaces.SchDoc, NetworkSwitch.SchDoc, Power-Supplies.SchDoc, Sensors.SchDoc]
2021-10-10 changes made to eth switch due to schematic error, schematic and PCB fixed
    [ComputeModule.SchDoc, HAB-Main-Flight-Computer-Card-Template.PrjPcb, Interfaces.SchDoc, NetworkSwitch.SchDoc, Power-Supplies.SchDoc]
2021-10-19 rev1a complete
    [HAB-Main-Flight-Computer-Card-Template.PrjPcb]
2021-12-12 making sure everything is up to date
    [Power-Supplies.SchDoc]
